fwachsmuth/Synkino/README.md

# Synkino
Allows sound playback synchronised to a running, jittery Super 8 projector
