fwachsmuth/Synkino/KiCad-PCBs/Synkino/datasheets/1.3inch-SH1106-OLED-Dimensions.jpg

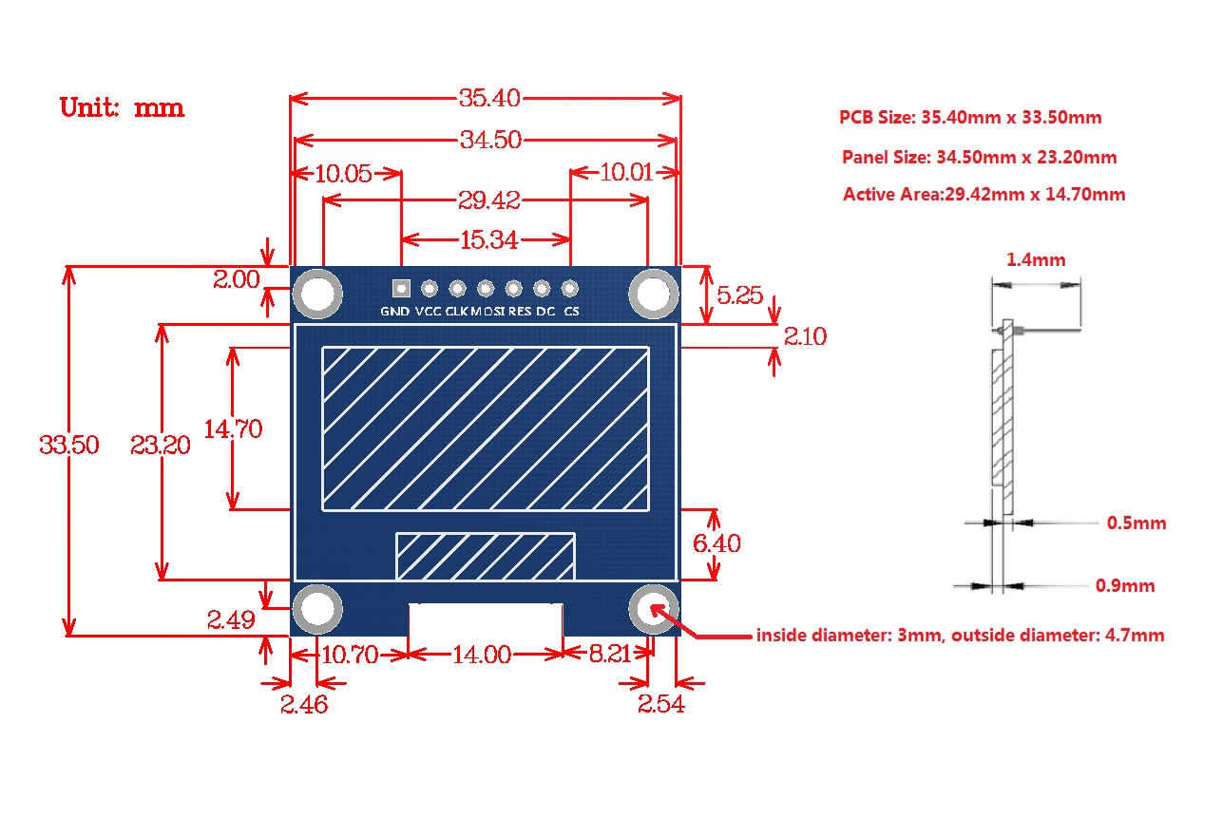
KiCad-PCBs/Synkino/datasheets/1.3inch-SH1106-OLED-Dimensions.jpg
