fwachsmuth/Synkino/KiCad-PCBs/Synkino/datasheets/AAC801J-13.jpg

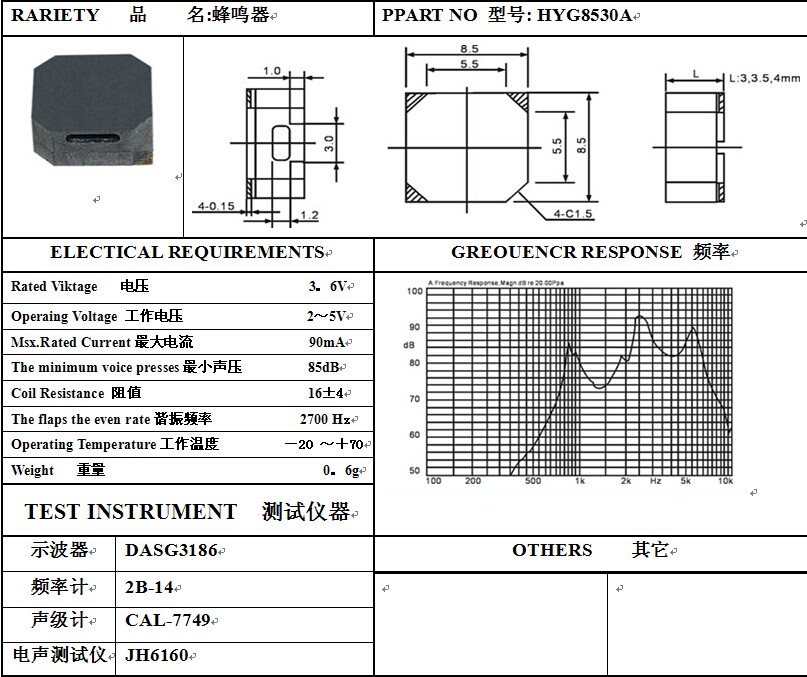
KiCad-PCBs/Synkino/datasheets/AAC801J-13.jpg
