fwachsmuth/Synkino/KiCad-PCBs/Synkino/images/black.png_Combined_Bottom.png

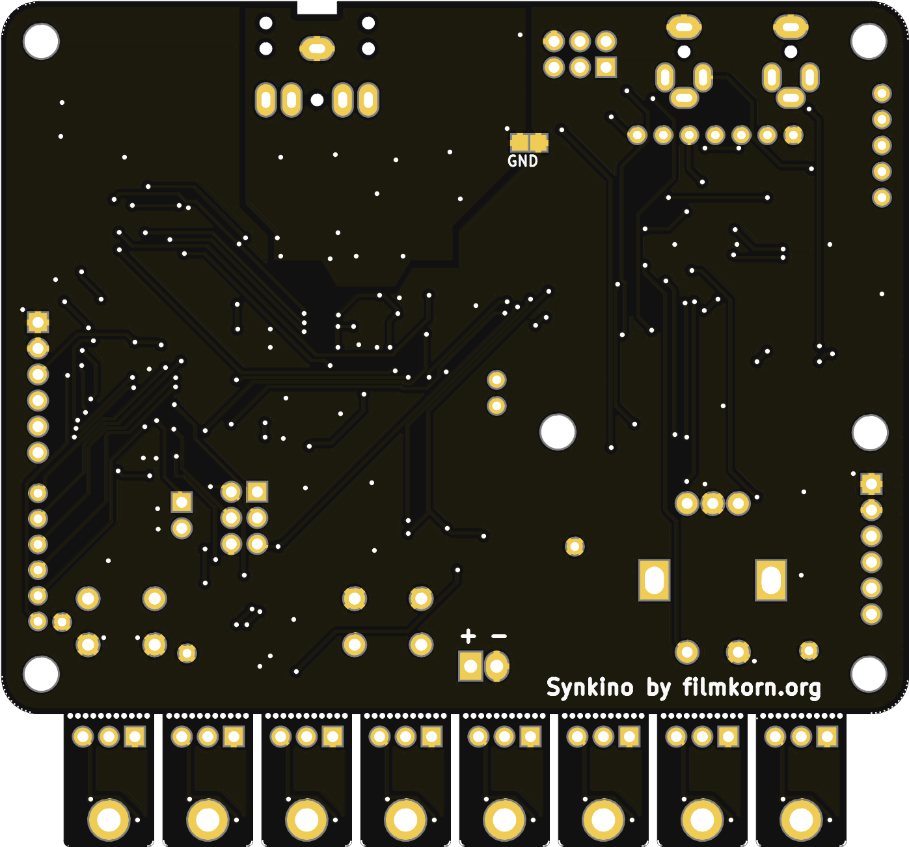
KiCad-PCBs/Synkino/images/black.png_Combined_Bottom.png
