fwachsmuth/Synkino/KiCad-PCBs/Synkino/images/black.png_Combined_Top.png

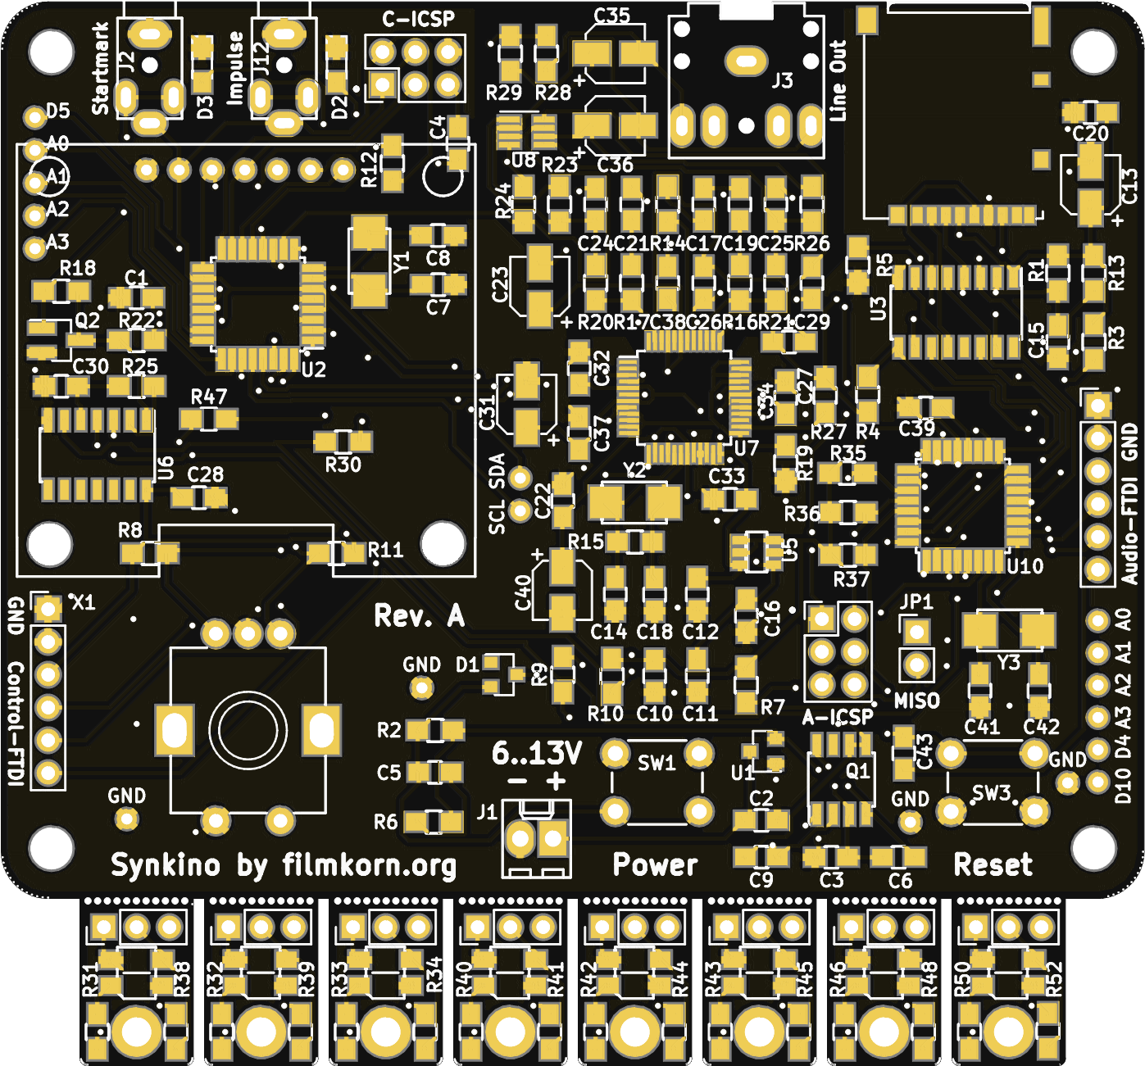
KiCad-PCBs/Synkino/images/black.png_Combined_Top.png
