fwachsmuth/Synkino/KiCad-PCBs/Synkino/images/latching-push-button-power-toggle-switch-circuit-for-microcontroller.jpg

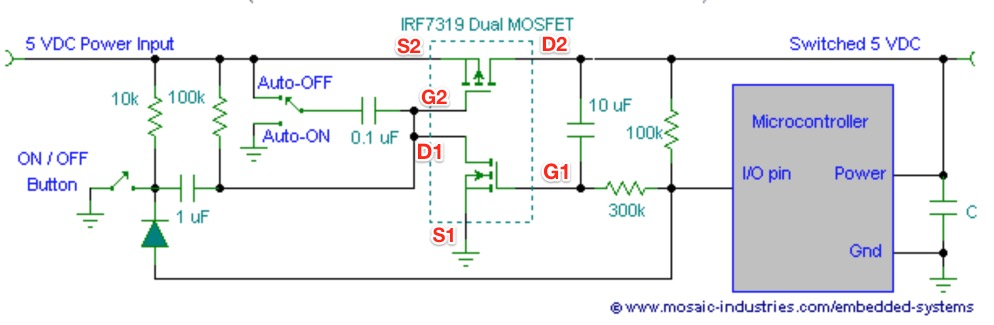
KiCad-PCBs/Synkino/images/latching-push-button-power-toggle-switch-circuit-for-microcontroller.jpg
