fwachsmuth/Synkino/KiCad-PCBs/Synkino/images/red.png_Combined_Top.png

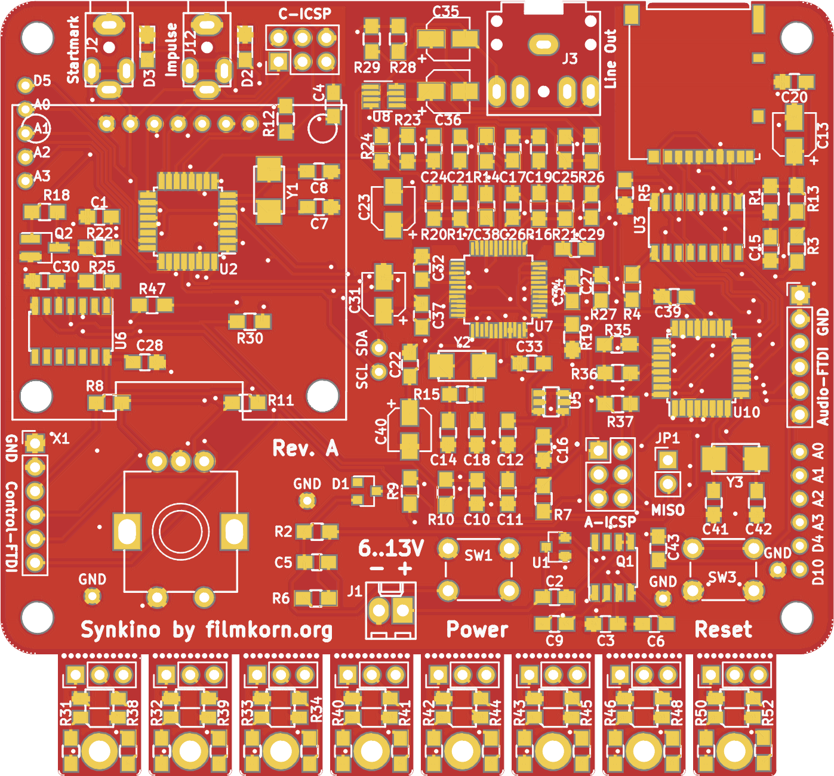
KiCad-PCBs/Synkino/images/red.png_Combined_Top.png
