fwachsmuth/Synkino/KiCad-PCBs/Synkino/images/Synkino-Black.png

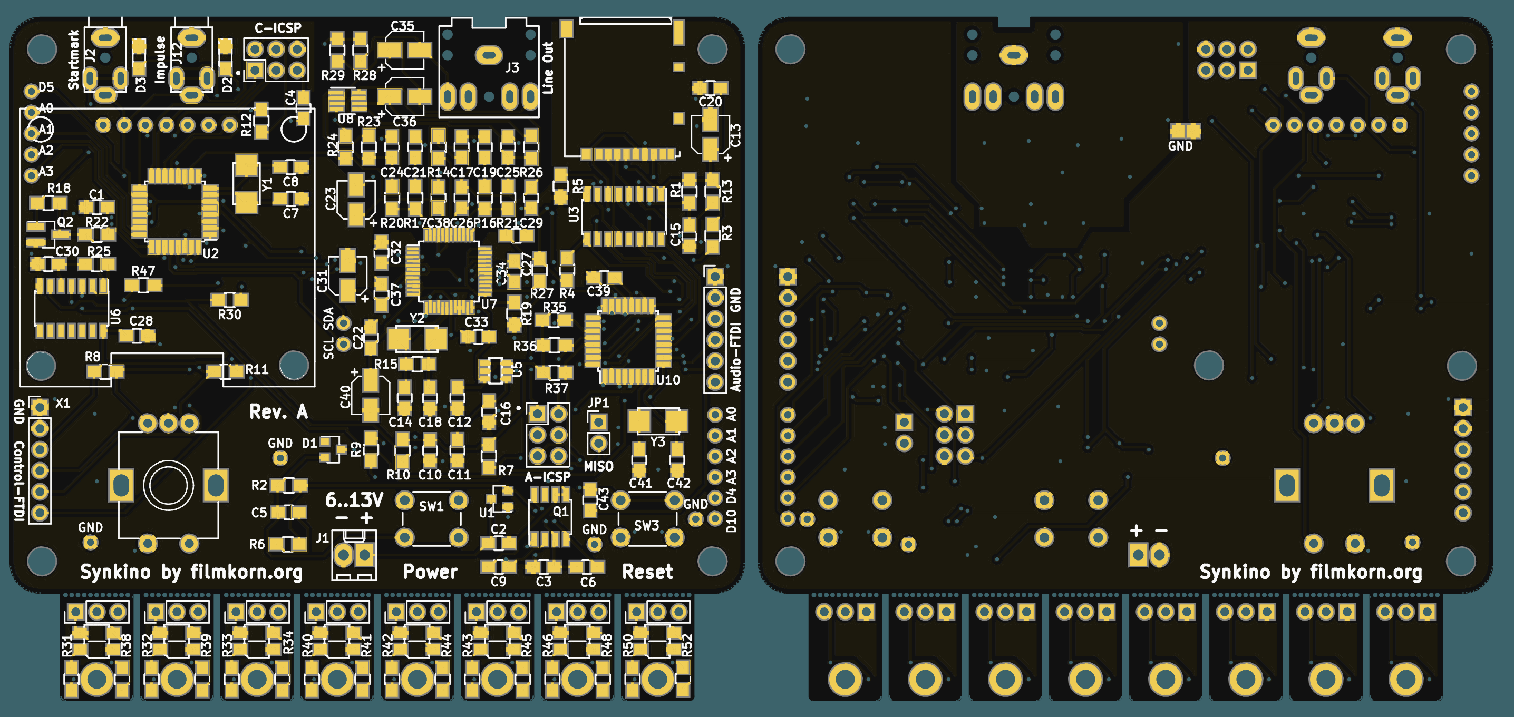
KiCad-PCBs/Synkino/images/Synkino-Black.png
