fwachsmuth/Synkino/KiCad-PCBs/Synkino/images/white.png_Combined_Bottom.png

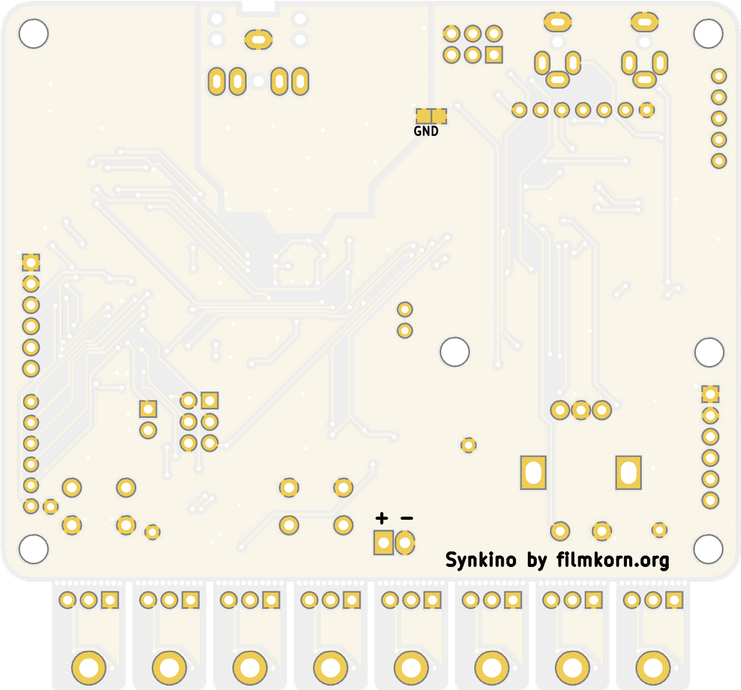
KiCad-PCBs/Synkino/images/white.png_Combined_Bottom.png
