fwachsmuth/Synkino/KiCad-PCBs/Synkino/images/white.png_Combined_Top.png

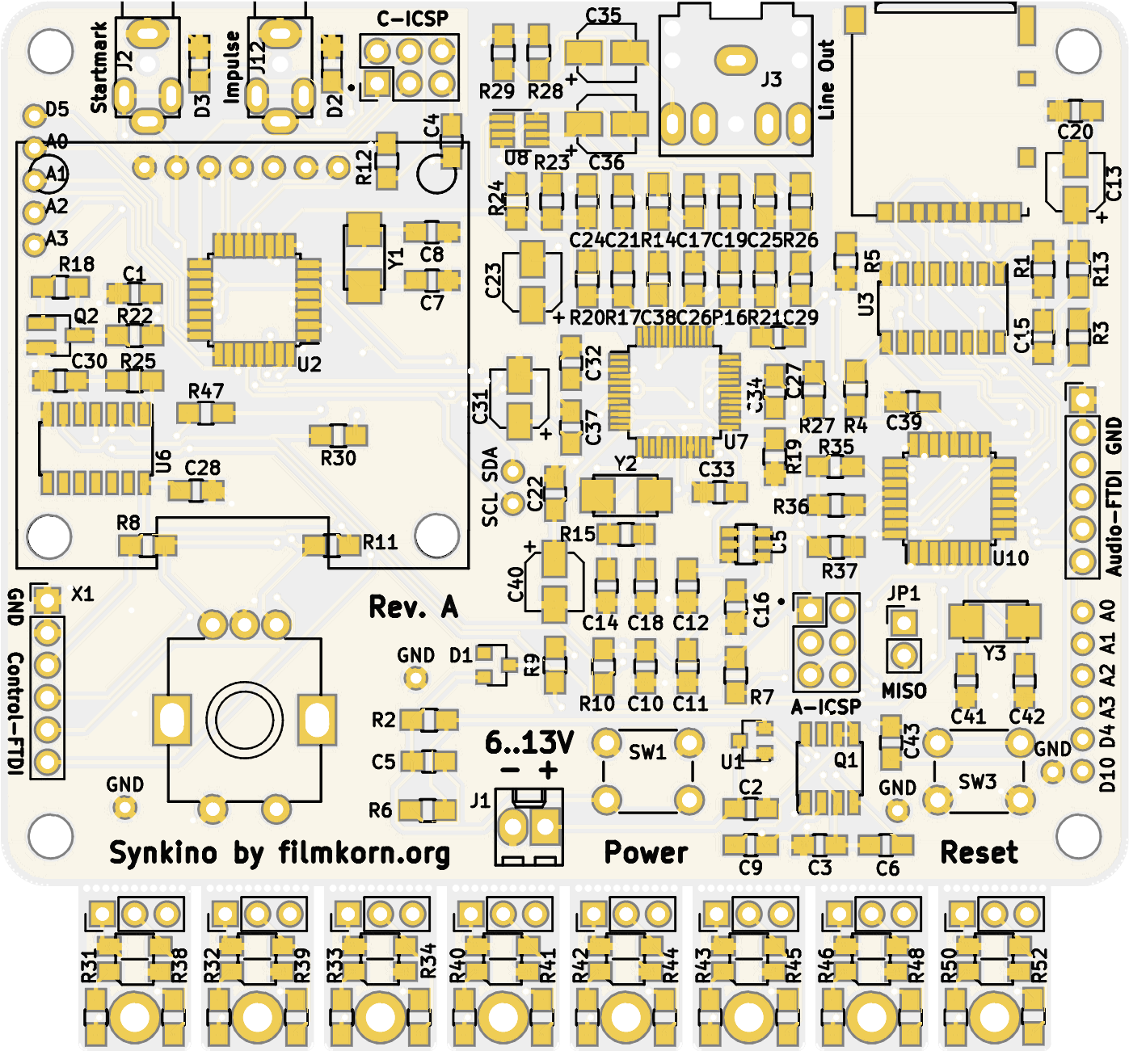
KiCad-PCBs/Synkino/images/white.png_Combined_Top.png
