fwachsmuth/Synkino/KiCad-PCBs/Synkino/Synkino_Schematics.pdf

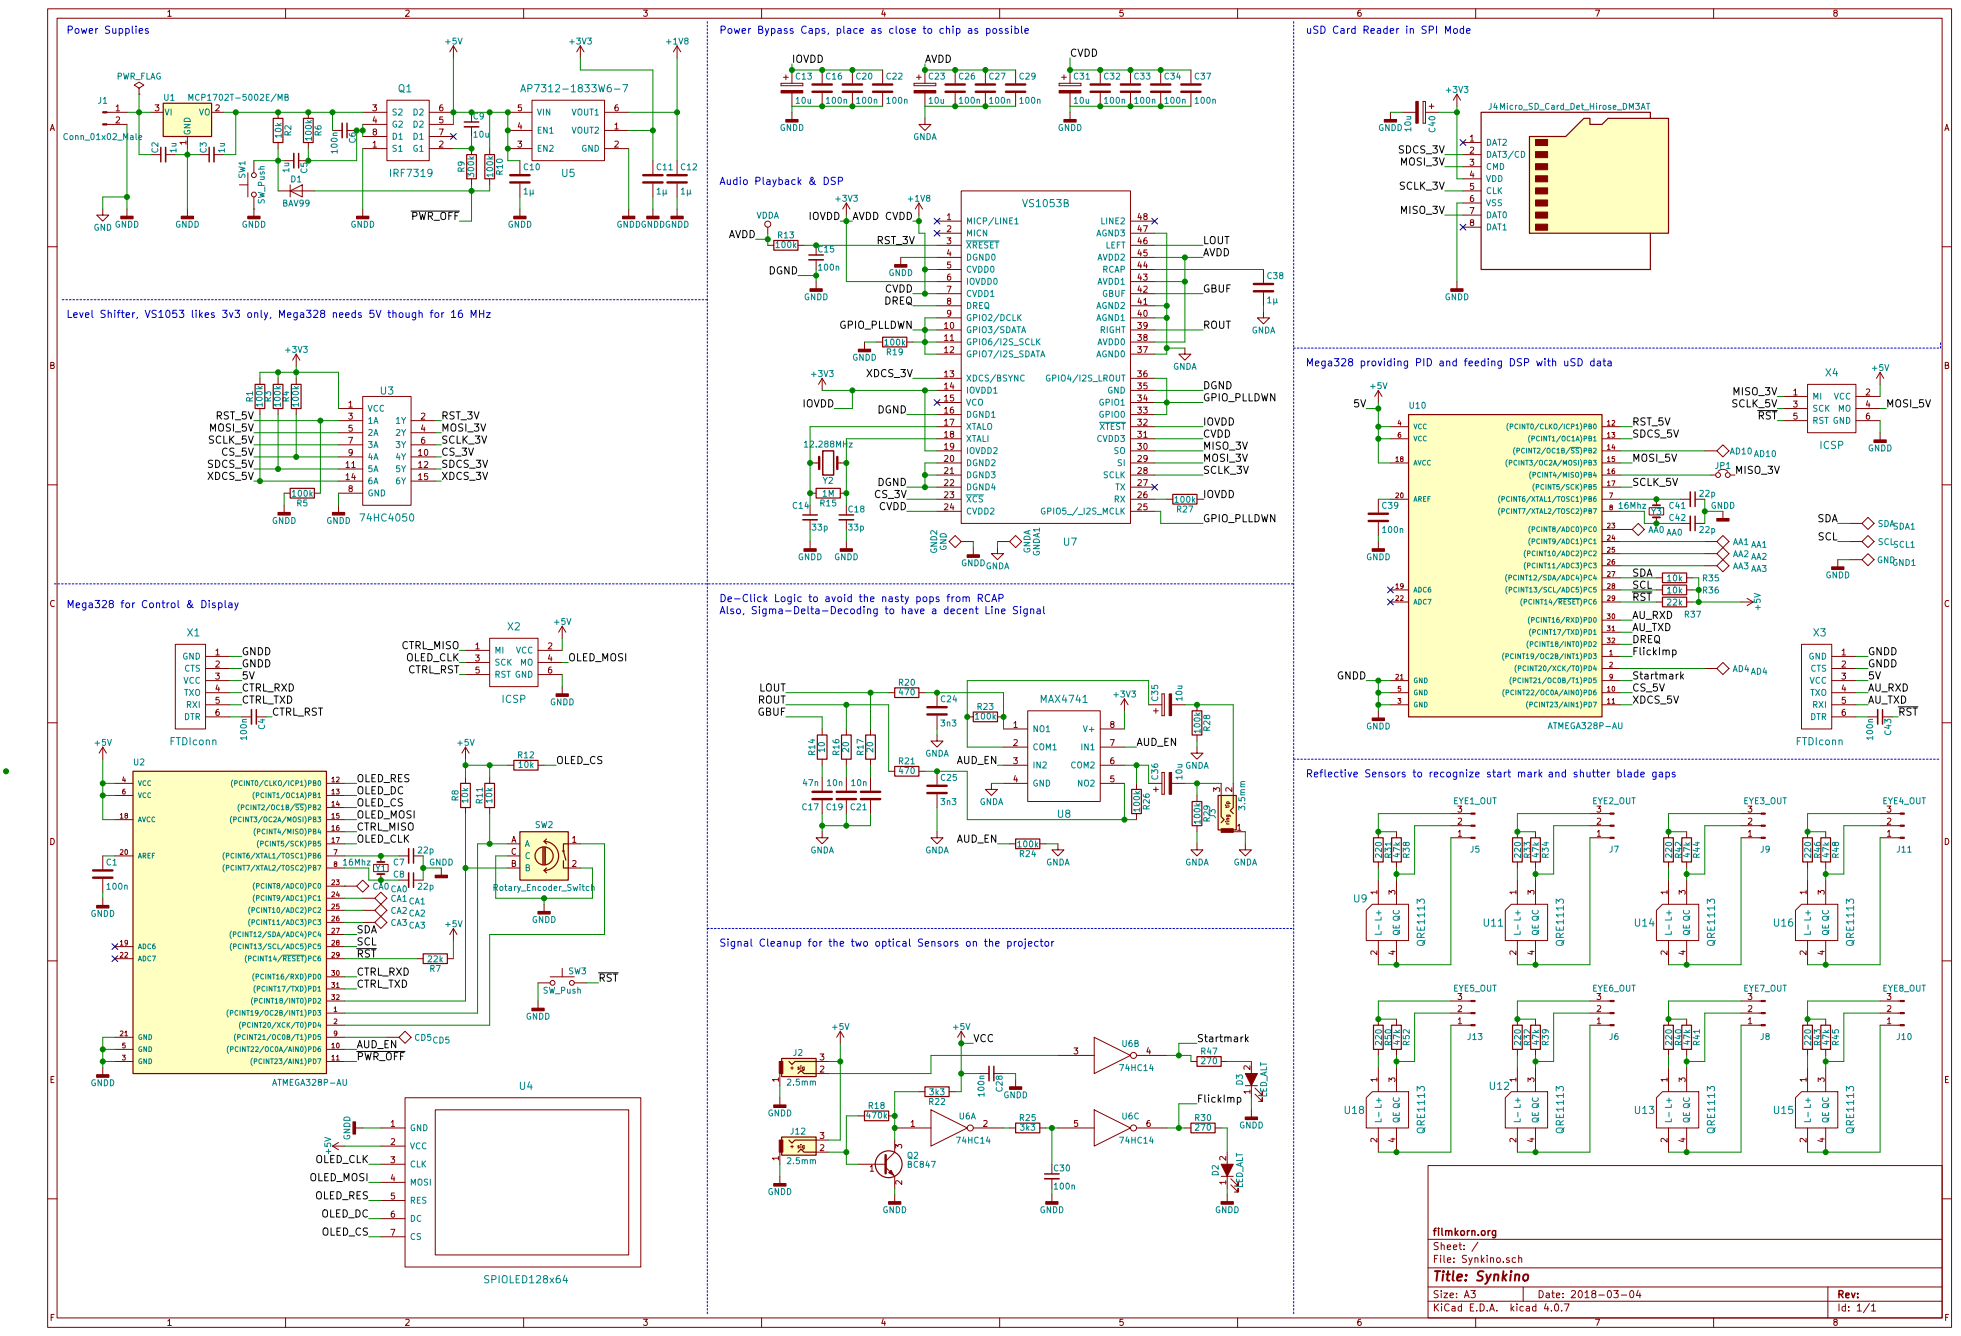
[picture p11: page 1]

Power Bypass Caps, place as close to chip as possible

and shutter blade gaps GNDDGNDA GND

Level Shifter, VS1053 likes 3v3 only, Mega328 needs 5V though for 16 MHz

Mega328 providing PID and feeding DSP with uSD data

De-Click Logic to avoid the nasty pops from RCAP
Also, Sigma-Delta-Decoding to have a decent Line Signal

Signal Cleanup for the two optical Sensors on the projector

File: Synkino.sch Sheet: / filmkorn.org
