fwachsmuth/Synkino/(commit log)

2018-01-06 move ppm adjustment our of the ISR. This seems to avoid crashes.
    [Synkino_Audio.ino]
2018-01-06 Initial i2C command receiver
    Uses byte (command) and long (parameter)
2018-01-07 Make start mark detection work. And i2c. And the initial state machine. Yay!
2018-01-07 make ongoing ppm correction work after sync'd start
    [Synkino_Audio.ino, Synkino_Auge.ino]
2018-01-07 prepare for PID
2018-01-08 Initial totalFrameCounter. Noise might pollute our counts. :(
    [Synkino_Audio.ino, Synkino_Auge.ino]
2018-01-09 Re-sync after 5 film seconds (e.g. 90 frames), not real seconds.
2018-01-10 avoid bursting re-sync attempts, clean up debug output
    [Synkino_Audio.ino, Synkino_Auge.ino]
2018-01-10 sync delta correctly calculated at any time :)
    [Synkino_Audio.ino, Synkino_Auge.ino]
2018-01-10 State is okay, but the carryover of out-of-bounds ppm corrections is buggy.
    [Synkino_Audio.ino, Synkino_Auge.ino]
2018-01-12 YESSSSS -- PID-Controller works an just ONE board for audio and regulation!
2018-01-13 Better pid params
2018-01-13 allow to read lost-samples counter with 'a'. Seems not to increase.
2018-01-16 smoothing and actually using the smoothed signal. Better, but still oscillating like hell
    [Synkino_Audio.ino]
2018-01-20 Calibrate the PID. WOrks pretty well with t610 now. :)
2018-01-20 fixes evil bug with int overload
    [Synkino_Audio.ino]
2018-01-20 Allow PID remote control from Frontend, fix ugly int overflow
    [Synkino_PID_ConfigHelper.ino]
2018-01-20 re-config the PID
2018-01-20 recalibrate the pid
2018-01-21 Removing i2c for now, hoping we can stick to one board
2018-01-21 prove that Encoder-Reading works w/o Interrupts
2018-01-21 cleans up encoder counting
2018-01-21 remove Encoder and Display from Code. There is simply not enough RAM for this.
2018-01-28 restore menu position after track selection
2018-01-28 fixes unselectability of menu items that where used just right before
    [Synkino_Frontend.ino]
2018-01-28 fix graphical glitch when returning from Track Selector
    [Synkino_Frontend.ino]
2018-01-28 clean up variables, fix track-selector re-entrance bug
    [Synkino_Frontend.ino]
2018-01-28 Bugfree Menu, less global encoder vars
    [Synkino_Frontend.ino]
2018-01-28 enable i2c code again
2018-01-28 enable initial i2c code in front end
2018-01-28 add 0-padding to track names :)
2018-01-28 make dynamic track loading work :)
2018-01-30 Preparing both nodes to be i2c masters
2018-01-30 Scaffold i2c protocol
2018-01-30 More i2c Scaffolding
2018-01-30 make Frontend aware when track finished loading
2018-02-03 Display out of sync frame offset
2018-02-04 Make current character blink
2018-02-04 Switch to lower case after first character
2018-02-04 make sure to not draw current character during long button push
2018-02-04 Do not store last current character when exiting
2018-02-05 add shutter blade # and PID control inputs
2018-02-06 fix projector name overflow
    [Synkino_Frontend.ino]
2018-02-06 "Select" is better than "Chose" when switching Projectors.
2018-02-06 Fix double Serial Output of d.new command
    [Synkino_Audio.ino]
2018-02-07 correct EEPROM struct offset to make space for lastProjectorUsed byte
    [Synkino_Frontend.ino]
2018-02-07 fixes charIndex Problems due to booleans. Doh.
    [Synkino_Frontend.ino]
2018-02-07 Save Flash by avoiding strncopy (and strcpy instead)
    [Synkino_Frontend.ino]
2018-02-07 Scaffolding Projector Deletion. There are Bugs.
    [Synkino_Frontend.ino]
2018-02-07 Fixes storing active Projector
    [Synkino_Frontend.ino]
2018-02-07 fix active Projector byte after creating a new one
    [Synkino_Frontend.ino]
2018-02-08 Finally fix the weird EEPROM oddities. NTS: get != read. Doh.
    [Synkino_Frontend.ino]
2018-02-08 Fix ghost string chunks in renaming sessions
    [Synkino_Frontend.ino]
2018-02-09 Add Encoder Lib (not sure if changed)
2018-02-11 Add KiCad Project to git
    [Synkino.kicad_pcb, Synkino.sch]
2018-02-11 make KiCAD part portable
    [Synkino.kicad_pcb, Synkino.sch]
2018-02-12 wip Schematics
    [Synkino.sch]
2018-02-16 Adding files
    [Synkino.sch]
2018-02-16 Adding more files
    [Adafruit VS1053 Breakout.brd, Adafruit VS1053 Breakout.sch]
2018-03-03 Adding Sigma-Delta Reconstruction Filter
    [Synkino.sch]
2018-03-03 Adding de-click analog switch for delayed audio power-on
    [Synkino.sch]
2018-03-03 add Max4741 analog switch lib
2018-03-03 Add power decoupling caps
    [Synkino.sch]
2018-03-03 Adding uSD Card
    [Synkino.sch]
2018-03-03 Schematics Progress
    [Synkino.sch]
2018-03-04 Adding 5V
    [Synkino.sch]
2018-03-04 Add Pro Mini Schematics for reference
2018-03-04 Adding 328P for Audio
    [Synkino.sch]
2018-03-04 Adding SPI OLED 64x128 Display
2018-03-04 Adding 2nd 328 and Control Components
    [Synkino.sch]
2018-03-04 Schematics complete?
    [Synkino.sch]
2018-03-04 Prepare for Audio_Enable
    [Synkino.sch]
2018-03-04 Adding ICSP connectors
    [Synkino.sch]
2018-03-04 Adding ICSP to both uCs
    [Synkino.sch]
2018-03-04 FTDI connector
2018-03-04 Adding FTDI Jumpers
    [Synkino.sch]
2018-03-04 Fixing PSU
    [Synkino.sch]
2018-03-05 Adding two Eyes
    [_saved_Synkino.sch]
2018-03-05 Adding Power Management
    [Synkino.sch]
2018-03-06 latch switch trick
2018-03-06 Fixing coupling cap polarity
    [_saved_Synkino.sch]
2018-03-06 Fixing PSUs
    [Synkino.sch]
2018-03-06 Schematics complete
    [Synkino.sch]
2018-03-06 Add Test Pins for unused GPIOs, lots of clean up
    [Synkino.sch]
2018-03-08 Project Cleanup, make it distributable
    [Synkino.sch, _saved_Synkino.sch]
2018-03-08 Adding Audio Jack Footprint
2018-03-08 Footprint for SD-Card reader
2018-03-08 Fixing the BC847 Pinout.
    [Synkino.sch]
2018-03-09 Crystal Footprint
2018-03-12 Fix Footprint
2018-03-12 Fixing Test Points wip
    [Synkino.kicad_pcb]
2018-03-12 getting wild on the pcb
    [Synkino.kicad_pcb, _saved_Synkino.sch]
2018-03-13 sloooowly getting there.
    [Synkino.kicad_pcb]
2018-03-13 Adding mounting holes
    [Synkino.kicad_pcb]
2018-03-13 Many more Eyes
    [Synkino.kicad_pcb, Synkino.sch, _saved_Synkino.sch]
2018-03-14 continue on big mac
    [Synkino.sch]
2018-03-14 8 eyes should be enough
    [Synkino.kicad_pcb, Synkino.sch]
2018-03-14 Seems complete :)
    [Synkino.kicad_pcb, _saved_Synkino.sch]
2018-03-14 Two ground planes
    [Synkino.kicad_pcb]
2018-03-16 Better Power Button Position
    [Synkino.kicad_pcb]
2018-03-16 added 8 eyes
    [Synkino.kicad_pcb]
2018-03-16 8 eyes shielded
    [Synkino.kicad_pcb]
2018-03-16 Getting there
    [Synkino.kicad_pcb, Synkino.sch]
2018-03-16 Finalizing PCB
    [Synkino.kicad_pcb, _saved_Synkino.sch]
2018-03-16 DRC Sign-off
    [Synkino.kicad_pcb]
2018-03-16 Add some text
    [Synkino.kicad_pcb]
2018-03-16 Everything connected
    [Synkino.kicad_pcb, _saved_Synkino.sch]
2018-03-16 This was ordered
    [Synkino-B.Cu.gbl, Synkino-B.Mask.gbs, Synkino-B.SilkS.gbo, Synkino-F.Cu.gtl, Synkino-F.Mask.gts, Synkino-F.SilkS.gto, Synkino.drl, Synkino.drl.drl]
2018-03-16 Better Gerber
    [Synkino-B.Cu.gbl, Synkino-B.Mask.gbs, Synkino-B.SilkS.gbo, Synkino-Edge.Cuts.gko, Synkino-F.Cu.gtl, Synkino-F.Mask.gts, Synkino-F.SilkS.gto]
2018-03-16 Some PCB Renditions
2018-03-17 Fixed the U1 footprint
    [Synkino.kicad_pcb, _saved_Synkino.sch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]
2018-03-17 Making Power button bigger
    [Synkino.kicad_pcb]
2018-03-17 New Gerbers
    [Synkino-B.Cu.gbl, Synkino-B.Mask.gbs, Synkino-B.SilkS.gbo, Synkino-Edge.Cuts.gko, Synkino-F.Cu.gtl, Synkino-F.Mask.gts, Synkino-F.SilkS.gto, Synkino.drl.drl]
2018-03-17 Bit more GND planes
    [Synkino.kicad_pcb]
2018-03-17 More Ground Planes, Make Pwr Button optional
    [Synkino.kicad_pcb, Synkino.sch, _saved_Synkino.sch]
2018-03-17 Somehow, Holes are gray :(
    [Synkino-B.Cu.gbl, Synkino-B.Mask.gbs, Synkino-B.SilkS.gbo, Synkino-Edge.Cuts.gko, Synkino-F.Cu.gtl, Synkino-F.Mask.gts, Synkino-F.SilkS.gto, Synkino.drl]
2018-03-18 New footprint for MAX4741
2018-03-18 Adapt for wider MAX4741 version (cheaper)
    [Synkino.kicad_pcb]
2018-03-18 Rev. B
    [_saved_Synkino.sch]
2018-04-01 Kalle safe :)
    [BOM.xlsx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]
2018-04-02 Tweaks & Fixes Allow editing max proctor length names \o/
    [Synkino_Frontend.ino]
2018-04-02 Bigger Power Switch Holes
    [Synkino.kicad_pcb]
2018-04-03 Schematics as PDF
    [_saved_Synkino.sch]
2018-04-03 Fix LDO pinout bug :(
    [Synkino.sch]
2018-04-03 Fixing PCB for LDO Pinout Bug
    [Synkino.kicad_pcb]
2018-04-04 Tweaks to make it work again
    [Synkino.sch]
2018-04-04 Fixing Reset (partially)
    [Synkino.sch]
2018-04-05 Temporary Encoder Fix
2018-04-05 Minor Schematic Tweaks
    [Synkino.kicad_pcb, Synkino.sch]
2018-04-09 Reverse Polarity Protection Tweaks
    [Synkino.kicad_pcb, Synkino.sch]
2018-04-10 Polarity Protection
    [Synkino.sch]
2018-04-11 Almost routed, D4 glitch still acts up
    [Synkino.kicad_pcb, Synkino.sch]
2018-04-13 Versuchen, den HEAD zu retten
    [Synkino.kicad_pcb, gitfup.kicad_pcb, gitfup.sch]
2018-04-13 wider 1v8 lines
    [Synkino.kicad_pcb]
2018-04-13 prepare second Order (Rev B)
    [Synkino-B.Cu.gbl, Synkino-B.Mask.gbs, Synkino-B.SilkS.gbo, Synkino-Edge.Cuts.gko, Synkino-F.Cu.gtl, Synkino-F.Mask.gts, Synkino-F.SilkS.gto, Synkino.drl]
2018-04-27 Add vs1053 plugin binaries
    [BOM.xlsx]
2018-04-29 BOM updates
    [BOM.xlsx]
2018-04-29 Use MAX Audio switch to enable audio path (all pops had happened here)
2018-04-29 Enable Soft Power-Off
2018-04-29 Fix Display Hole Position
    [Synkino.kicad_pcb]
2018-05-01 Better Error Handling Capabilities
    [Synkino_Audio.ino, Synkino_Frontend.ino]
2018-05-01 Now also handle "SD Card not found" error
    [Synkino_Audio.ino, Synkino_Frontend.ino]
2018-05-01 Fix returning correctly out of a file-not-found case
    [Synkino_Audio.ino, Synkino_Frontend.ino]
2018-05-01 Allow Exiting Track Selection Menu
2018-05-02 Auto PowerOff after 5 minutes of user inactivity
2018-05-02 BOM Update
    [BOM.xlsx]
2018-05-02 Actually, do not auto power-off during Playback or Pause State :)
2018-05-02 Format EEPROM when obviously containing junk (reduces crashes and weird behavior)
    [Synkino_Frontend.ino]
2018-05-03 Fix Track Selection with this new rotary encoder
    [Synkino_Frontend.ino]
2018-05-03 Some EEPROM Datasheets – lets try to keep the plugin off the SD card
2018-05-03 Allow changing Tracks without HW-Reset
    [Synkino_Audio.ino, Synkino_Frontend.ino]
2018-05-03 sync correction menu wip
    [Synkino_Frontend.ino]
2018-05-04 Minor i2c Protocol change
2018-05-04 Auto Power-Off in any Mode, to save some batteries while consumpton is still so high -.-
2018-05-04 Fixed a misnamed function
    [Synkino_Audio.ino]
2018-05-04 Allow Framewise SyncPos Correction during Playback :)
    [Synkino_Audio.ino, Synkino_Frontend.ino]
2018-05-04 Stop displaying unsync-status if actually in sync (lost i2c packets)
2018-05-04 Detect end of Track && die
2018-05-04 Let#s die more gracefully. And save some Power.
2018-05-10 Making FTDI and ICSP pins tighter
    [Synkino.kicad_pcb]
2018-05-10 Adjust SPI OLED footprint to actual size
    [Synkino.kicad_pcb]
2018-05-10 5th mounting hole for better encoder stability
    [Synkino.kicad_pcb]
2018-05-10 Adding Buzzer and EEPROM to schematic
    [Synkino.sch]
2018-05-10 Buzzer Footprint
2018-05-10 Fixing LED R
    [Synkino.sch]
2018-05-10 Start heavy Rev C reroutuing
    [Synkino.kicad_pcb]
2018-05-11 Rev C Routing "complete"
    [Synkino.kicad_pcb]
2018-05-11 Everything connected...
    [Synkino.kicad_pcb]
2018-05-11 Minor Clean-Ups
    [Synkino.kicad_pcb]
2018-05-11 All it needed was to burn the optiboot from the Arduino IDE. Definitely some Fuse Foo (BOOTRST?)
    [Synkino_Frontend.ino]
2018-05-11 Potentially fixes weird behaviour after EEPROM had been FF'd
    [Synkino_Frontend.ino]
2018-05-11 Fixing traces too close to screws
    [Synkino.kicad_pcb]
2018-05-11 SmallSetup doesn't work on 328.
    [Synkino_Frontend.ino]
2018-05-12 Prepare to have different encoder types configurable
2018-05-12 Add Pulldown R for SPI-OLED to allow ICSP usage while display is connected
    [Synkino.sch]
2018-05-12 Add 5V out, Add Pulldown-R for ICSP / OLED compat
    [Synkino.kicad_pcb, _saved_Synkino.sch]
2018-05-12 Mark GND on FTDI
    [Synkino.kicad_pcb]
2018-05-14 5 and 3v3 out
    [Synkino.kicad_pcb, Synkino.sch]
2018-05-21 Crank up i2c for 400 kHz
2018-05-21 gerber cleanup
    [Synkino-B.Cu.gbl, Synkino-B.Mask.gbs, Synkino-B.SilkS.gbo, Synkino-Edge.Cuts.gko, Synkino-F.Cu.gtl, Synkino-F.Mask.gts, Synkino-F.SilkS.gto, Synkino.drl]
2018-05-21 Final tweaks for Rev C
    [Synkino.kicad_pcb]
2018-05-21 Gerbers for Rev C
2018-05-21 Remove obsolete THs for 3.5mm jack
2018-06-17 Adding Assembly Helper Pics
2018-06-17 Switch to final encoder type
2018-06-17 Updating BOM with Pad Count
    [BOM.xlsx]
2018-06-19 Updating Inventory
    [BOM.xlsx]
2018-06-23 RevD, baby
    [Synkino.kicad_pcb]
2018-06-23 RevD Gerbers
2018-06-23 New Todos, removing unneeded files
    [BOM.xlsx, Synkino Kosten.xlsx]
2018-06-25 Debugging Blade Count Selection Bug
    [Synkino_Frontend.ino]
2018-12-17 Allows loading new and recreating old patches to/from i2c EEPROM
2018-12-17 Fixe that Shutter Blade Position was wrong when editing a Projector
    [Synkino_Frontend.ino]
2018-12-17 fixes accidentila deletion from Projector Names when editing them
    [Synkino_Frontend.ino]
2018-12-18 Fixing final 1.0 bugs
    [Synkino_Frontend.ino]
2018-12-18 Helpers to bootstrap the first round of made boards
2019-01-31 Slow down i2c a bit to avoid hick-ups on a busy other side
    [Synkino_Frontend.ino]
2019-01-31 Communicate Changes to current projector config to Audio Controller
2019-02-01 Fix Ogg physical sampling rate, add some debug output
    [Synkino_Audio.ino]
2019-02-02 Take care fo the fact that the Ogg Sample Countertakes 8 KiB of data before being valid (aka: don't control speed in the first second)
2019-02-02 Output CSV values to allow PID controller comparison
2019-02-02 Finally fixed the start-too-fast bug by compensating the FIFO buffer size in the actual sample count calculation. Yay!
    [Synkino_Audio.ino]
2019-02-02 Reduce ring buffer size to have the PID controller follow faster
2019-02-02 Attempt to get Samplerate from File
2019-02-03 avoid lost i2c signals by getting a little slower
    [Synkino_Audio.ino]
2019-02-03 Fix Low Fuse Bits to restore Arduino IDE programmability
2019-02-03 Shutdown after track until we have reset implemented
    [Synkino_Frontend.ino]
2019-02-03 Avoid one other pop on shutdown
    [Synkino_Frontend.ino]
2019-02-03 Allow Frontend to be reset by the Audio Player for continuous shows
    [Synkino_Frontend.ino]
2019-02-03 Fixed having two commands called RESET. Doh!
    [Synkino_Audio.ino, Synkino_Frontend.ino]
2019-02-03 Finally fixing the second playcount in cont. play
    [Synkino_Audio.ino]
2019-02-04 Attempt to fix speed glitch with cont. playback. Also, i2c delay re-introduced, watch this space
    [Synkino_Audio.ino]
2019-02-04 Now not wating for 8 KiB of samples before PID kicks in, to get to the bottom of this nasty "desired sample" bug
    [Synkino_Audio.ino]
2019-02-04 Zero out the PID's ring buffer between tracks
2019-02-04 Do not allow actualSampleCounter to be smaller than the previous read within a track's playback. Oh, and clean the ring buffer.
2019-02-04 Zero out the RIngbuffer afetr track change. For real.
2019-02-05 Say Hi to adaptive Samplerate Handling!
2019-02-06 Fix the endless "Loading..." Bug
    [Synkino_Audio.ino]
2019-02-06 Save a bit of power
2019-02-06 Fixing the "Can't select Track" bug and saving more power
    [Synkino_Frontend.ino]
2019-02-06 YA blind fix for the "can't select track" after powered auto-power-down bug. Why do I even care?
    [Synkino_Frontend.ino]
2019-02-06 Prevent Startmark Offset of 0
    [Synkino_Frontend.ino]
2019-02-06 Getting closer to fix the "audible buffer fill", but no fix yet
    [Synkino_Audio.ino]
2019-02-08 Super simple fix for occasionally lost CMD_STARTMARK_HIT message. When a time code comes in, we obviously found the start mark yet!
    [Synkino_Frontend.ino]
2023-11-20 KiCad 5 version, .gitignore
    [Synkino-2023-01-23-00-49-03.sch, Synkino.kicad_pcb, Synkino.kicad_sch]
2023-11-20 Deleting KiCad Backups
    [Synkino-BOM.csv]
2023-11-21 KiCad 8 converted
    [Synkino.kicad_pcb]
2023-11-21 Bul Footprint change for SMTA
    [Synkino.kicad_sch]
2023-11-22 Optimizing for SMTA (and sanity)
    [Synkino.kicad_pcb, Synkino.kicad_sch]
2023-11-22 No need for the Zener on the input side, UGS of this Mosfet is +-12V
    [Synkino.kicad_pcb]
2023-11-22 Eyes flattr (0402), wider 1.8V net, D7 gone, more SMTA prep
    [Synkino.kicad_pcb, Synkino.kicad_sch]
2023-11-22 Footprints updated to newer KiCad and SMTA versions
    [Synkino.kicad_pcb, Synkino.kicad_sch]
2023-11-23 Updating Reset Button, Footprints, adding 3v3 pane to Audio part
    [Synkino.kicad_pcb, Synkino.kicad_sch]
2023-11-23 DRC mostly happy now
    [Synkino.kicad_pcb, Synkino.kicad_sch]
2023-11-23 Updated legacy footprint associations
    [Synkino.kicad_sch]
2023-11-23 Lotsof cleanup
    [Synkino.kicad_pcb, Synkino.kicad_sch]
2023-11-23 Saving before we turn the 2nd GND plane into a VCC plane to remove a LOT of vias ans traces
    [Synkino.kicad_pcb]
2023-11-23 2nd GND plane exchanged thorugh a 5V plane. Tons of wires and vias removed
    [Synkino.kicad_pcb]
2023-11-24 Adding a Jumper to connect the GNGs. To Do: smaller QR1113 footrpint, move C13
    [Synkino.kicad_pcb, Synkino.kicad_sch]
2023-11-25 Updating QR1113 footprints to slim version
    [Synkino.kicad_pcb, Synkino.kicad_sch]
2023-11-25 Unroute the Level Shifter for more space...
    [Synkino.kicad_pcb]
2023-11-25 Rerouted Levelshifter to have space next to the uSD reader (for hand soldering)
    [Synkino.kicad_pcb]
2023-11-25 More Pane Coverage
    [Synkino.kicad_pcb]
2023-11-26 Ready for BOM / Pos
    [Synkino.kicad_pcb, Synkino.kicad_sch]
2023-11-26 swapping Power footprint to have square hole being GND; adding white box for SN# on back
    [Synkino.kicad_pcb, Synkino.kicad_sch]
2023-11-26 Changing 33p caps to 0603 to get them free
    [Synkino.kicad_pcb, Synkino.kicad_sch]
2023-11-27 Ready for a partial-assembly order
    [Synkino-B_Mask.gbs, Synkino-B_Paste.gbp, Synkino-B_Silkscreen.gbo, Synkino-Back.gbl, Synkino-Edge_Cuts.gm1, Synkino-F_Mask.gts, Synkino-F_Paste.gtp, Synkino-F_Silkscreen.gto]
2023-11-28 Changing to a full SMTA order... except the MCP1702 -.-
    [Synkino.kicad_sch]
2023-11-28 Exchanging 5V LDO for a cheaper type with more Amps and wider input range. Also, on stock. (Schema)
    [Synkino.kicad_sch]
2023-11-28 Updating Footprint for new LDO
    [Synkino.kicad_pcb]
2023-11-28 Adding Artwork <3
    [Synkino.kicad_pcb]
2023-11-28 Now *really* updating all changed footprints
    [Synkino-B_Mask.gbs, Synkino-B_Paste.gbp, Synkino-B_Silkscreen.gbo, Synkino-Back.gbl, Synkino-Edge_Cuts.gm1, Synkino-F_Mask.gts, Synkino-F_Paste.gtp, Synkino-F_Silkscreen.gto]
2023-11-28 Free'd U6 for better soldering
    [Synkino.kicad_pcb]
2023-11-29 This was ordered as Rev.E (5 pcs)
    [Synkino-B_Mask.gbs, Synkino-B_Paste.gbp, Synkino-B_Silkscreen.gbo, Synkino-Back.gbl, Synkino-Edge_Cuts.gm1, Synkino-F_Mask.gts, Synkino-F_Paste.gtp, Synkino-F_Silkscreen.gto]
2023-11-29 Repo Cleanup
    [Synkino-B_Mask.gbs, Synkino-B_Paste.gbp, Synkino-B_Silkscreen.gbo, Synkino-Back.gbl, Synkino-Edge_Cuts.gm1, Synkino-F_Mask.gts, Synkino-F_Paste.gtp, Synkino-F_Silkscreen.gto]
2024-05-07 KiCad 8, fixing bootstrap paths
    [Synkino.kicad_sch]
2024-05-07 Library Paths fixed, but the reset switch is still wrong
    [Synkino.kicad_pcb, Synkino.kicad_sch]
2024-05-07 SW3 Footprint updated, but netlist noct yet
    [Synkino.kicad_pcb, Synkino.kicad_sch]
2024-05-07 Fixed SW3 FP, added potential Board Todos
    [Synkino.kicad_pcb, Synkino.kicad_sch]
2024-05-08 Strengthening the Display Connecting Traces
    [Synkino.kicad_pcb, Synkino.kicad_sch]
2024-05-09 FIxing Rev.E Gerbers
2024-05-10 Strengthening Eye Traces for better tear-off safety
    [Synkino.kicad_pcb]
2024-05-11 Adding Terminal Blocks instead of Dupont Pins, Improve 5V wiring, Schemtics cleanups
    [Synkino.kicad_pcb, Synkino.kicad_sch]
2024-05-12 using SMT buttons, realigned
    [Synkino.kicad_pcb, Synkino.kicad_sch]
2024-05-12 Repalced pricy MAX7471 with better Gansai Switch
    [Synkino.kicad_sch]
2024-05-12 MAX4741 exchanged on PCB, improved audio paths
    [Synkino.kicad_pcb, Synkino.kicad_sch]
2024-05-12 Fixing TP Labels and various footprints
    [Synkino.kicad_pcb, Synkino.kicad_sch]
2024-05-12 Footprint Updates
    [Synkino.kicad_pcb, Synkino.kicad_sch]
2024-05-12 Holding the OLED by a capacitor
    [Synkino.kicad_pcb, Synkino.kicad_sch]
2024-05-13 Updating 7414 symbols
    [Synkino.kicad_pcb, Synkino.kicad_sch]
2024-05-13 Working thorugh ERC errors
    [Synkino.kicad_pcb, Synkino.kicad_sch]
2024-05-13 Zero (legit) ERC errors
    [Synkino.kicad_sch]
2024-05-14 Adding some TP labels
    [Synkino.kicad_pcb, Synkino.kicad_sch]
2024-05-20 Updating audio code to work with the public vs1053-for-sdfat lib
    [Synkino-Panel.kicad_pcb]
2024-05-25 Pre Footprint-Fixing State
    [Synkino-Panel.kicad_pcb, Synkino.kicad_pcb, Synkino.kicad_sch]
2024-05-25 all nc pins added to symbols
    [Synkino.kicad_pcb, Synkino.kicad_sch]
2024-05-25 0 DRC Errors (but Warnings), ICSP fp displaced
    [Synkino.kicad_pcb, Synkino.kicad_sch]
2024-05-25 ERC & DRC happy, except some irrelvant warnings
    [Synkino.kicad_pcb]
2024-05-25 Removing some lose ends
    [Synkino.kicad_pcb]
2024-05-26 BOM Updates, more datasheets
    [Synkino.kicad_pcb, Synkino.kicad_sch]
2024-05-26 Rev.G as ordered, inclduing new panel
    [Synkino-Panel.kicad_pcb]
2024-05-26 Updating RevG Gerbers to have identical silkscreen
    [Synkino.kicad_pcb]
2024-06-03 Bump to 1.3 — Adding functionality to disable Auto Power Off by connectiong a switch or Jumper from CA0 to GND
2024-06-04 Planning Rev H
    [Synkino.kicad_pcb]
2024-06-04 Sensor Terminals mounted from the bottom
    [Synkino.kicad_pcb]
2024-06-04 ICSPs flipped to bottom
    [Synkino.kicad_pcb]
2024-06-04 Removed Bottom Mid Support Hole, flipped Powert Terminal, aligning font sizes
    [Synkino.kicad_pcb]
2024-06-05 Put Impulse LED behind Logo's Lens, move Display Cutout 0.9mm lower and 0.5,, to the left, make Projector artwork partially translucent, get HASL on the artwork reels, make Power Button Hole have 1mm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
    [Synkino-Panel.kicad_pcb, Synkino.kicad_pcb]
2024-06-05 Panel Rev.B as ordered
    [Synkino-Panel.kicad_pcb]
2024-06-08 Progmem Reduction Hints, D2 now white + R changed to 470
    [Synkino.kicad_pcb, Synkino.kicad_sch]
2024-06-08 Displaced Pin-Headers 0.1mm further
    [Synkino.kicad_pcb]
2024-06-09 Add bottom TPs for Sensor-In, Audio out and Power (test jig prep)
    [Synkino.kicad_pcb, Synkino.kicad_sch]
2024-06-09 Moving Eyes to separate Board to allow V-Cuts instead of Mousebites
    [Synkino.kicad_pcb, Synkino.kicad_sch, Synkino_Eyes_KiCAD.kicad_pcb, Synkino_Eyes_KiCAD.kicad_sch]
2024-06-11 Panelized Eyes separated from main Board, allowing V-Cuts
    [Synkino_Eyes_KiCAD.kicad_pcb, Synkino_Eyes_KiCAD.kicad_sch, Synkino_Eyes_Panlized.kicad_pcb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]
2024-06-11 Move Eys to separate Board (panelized)
    [Synkino.kicad_pcb]
2024-06-12 Updating panel to let Projector no longer be translucent
    [Synkino-Panel.kicad_pcb]
2024-06-12 Adding datasheets for a fancy 9V connector, and all you get is a lousy silkscreen rect ¯\_(ツ)_/¯
    [Synkino.kicad_pcb]
2024-06-12 Very very very pragmatic Back-Panel
    [back-panel.kicad_pcb]
2024-06-16 Adding Battery Holder, Battery connector
    [Synkino.kicad_pcb, Synkino.kicad_sch, back-panel.kicad_pcb]
2024-06-16 Adding screw holes to reach sensor's terminal blocks
    [back-panel.kicad_pcb]
2024-06-16 Adding a GND plane to the back panel
    [back-panel.kicad_pcb]
2024-06-16 Rev.H as ordered
    [Synkino.kicad_pcb, Synkino.kicad_sch, back-panel.kicad_pcb]
2024-07-02 Saving before cleaning up cluttered projects
    [back-panel.kicad_pcb]
2024-07-02 Re-Organize the various kicad folders and projects into something more scalable
    [Adafruit VS1053 Breakout.brd, Adafruit VS1053 Breakout.sch, Eye.kicad_pcb, Eye.kicad_sch, Frontpanel.kicad_pcb, Synkino-2023-01-23-00-49-03.sch, Synkino.kicad_pcb, Synkino.kicad_sch]
2024-07-02 Improving Battery Holder Footprint, adding polarity marks, going back from Rev.H to Rev.C (do not sync Revs)
    [back-panel.kicad_pcb]
